nguyenduchan/keyboard_rs485/hardware/bom.csv

Qty | RefDes | Value | Footprint | Layer | Manufacturer | MPN | Notes | LCSC (JLCPCB) | JLC type
1 | U1 | STM32G030F6P6 | TSSOP-20 | Top | ST | STM32G030F6P6 | MCU; PA1 DE PA2/PA3 USART2; PA4-PA6 TM1638 open-drain; PA7 còi | C529330 | Extended
1 | U6 | TM1638 | SOP-28 300mil | Top | Titan Micro | TM1638 | Quét 2 module 4 số + 8 LED + 16 phím; thay thế AiP1638 / GN1638 | C19187 | Extended
1 | U3 | SP3485EN | SOIC-8 | Top | MaxLinear | SP3485EN-L/TR | RS485 3.3V | C8963 | Basic
1 | U4 | XL1509-5.0E1 | SOP-8 | Top | XLSEMI | XL1509-5.0E1 | Buck 24V→5V; FB nối +5V_RAW; ~EN nối GND | C61063 | Basic
1 | U5 | AMS1117-3.3 | SOT-223 | Top | AMS | AMS1117-3.3 | LDO 5V→3.3V | C6186 | Basic
2 | D8 DREV | SS34 | SMA | Top |  | SS34 | D8 diode buck; DREV chống ngược cực đầu vào | C8678 | Basic
1 | TVS1 | SMAJ28CA | SMA | Top |  | SMAJ28CA | TVS 2 chiều 28V tại VIN_PROTECT | C19077546 | Preferred
1 | TVS2 | PSM712-LF-T7 | SOT-23 | Top | ProTek | PSM712-LF-T7 | ESD/surge RS485 A/B, 34A 8/20us | C32677 | Basic
1 | F1 | mSMD050-33V | 1812 | Top |  | mSMD050-33V | Cầu chì tự phục hồi đầu vào | C70112 | Extended
1 | L1 | 47uH | SMD 6045 (6x6 mm) | Top |  | SWPA6045S470MT | Cuộn buck; Isat ≥ 0.8A | C36414 | Extended
4 | FBIN FB1 FB2 FB5V | Ferrite bead 0805 | 0805 | Top |  |  | FBIN GZ2012D601TF 600R; FB1/FB2/FB5V GZ2012D101TF 100R | C1017 / C1015 | Basic
1 | C4 | 470uF 35V | CP_Elec 10x10.5 SMD | Top |  | RVT1V471M1010 | Bulk +24V | C3350 | Extended
2 | C2 C22 | 220uF 10V | CP_Elec 6.3x5.4 SMD | Top |  | RVT1A221M0605 | +5V_RAW / +5V | C72494 | Extended
2 | C16 C19 | 2.2uF 50V X7R | 1206 | Top |  |  | HF tại VIN buck / VIN_PROTECT (bulk do C4) | C50254 | Basic
1 | C3 | 22uF | 0805 | Top |  |  | AMS1117 ngõ ra | C45783 | Basic
2 | C7 CLED3 | 10uF | 0805 | Top |  |  | AMS1117 ngõ vào; TM1638 VDD bulk | C15850 | Basic
2 | C15 C17 | 100nF 50V | 0805 | Top |  |  | HF trên rail 24V | C49678 | Basic
7 | C5 C18 CVDD1 CNRST CM3 CLED1 CLED2 | 100nF | 0805 | Top |  |  | Decoupling | C49678 | Basic
2 | R47A R47B | 47R | 0805 | Top |  |  | UART nối tiếp | C17714 | Basic
1 | RDE | 10k | 0805 | Top |  |  | Kéo DE xuống (mặc định nhận) | C17414 | Basic
1 | RBZG | 100k | 0805 | Top |  |  | Kéo cổng QBZ xuống | C149504 | Basic
3 | RSTB RCLK RDIO | 4.7k | 0805 | Top |  |  | Kéo lên +5V_LED cho 3 dây TM1638 | C17673 | Basic
2 | RBIAS_A RBIAS_B | 560R | 0805 | Top |  |  | Bias failsafe RS485 | C28636 | Basic
1 | RTERM | 120R | 0805 | Top |  |  | Termination (bật bằng JTERM) | C17437 | Basic
1 | JTERM | Solder jumper | SMD | Top |  |  | Hàn tắt ở node cuối bus (không phải linh kiện) |  | —
1 | NT1 | Net tie | SMD | Top |  |  | GND_PWR ↔ GND (không phải linh kiện) |  | —
1 | QBZ | 2N7002 | SOT-23 | Top |  | 2N7002 | Lái còi | C8545 | Basic
1 | BZ1 | Active buzzer 5V 12x9.5 | THT RM7.6 | Top (THT) |  | TMB12A05 | Còi chủ động; tự hàn |  | THT tự hàn
2 | DS1 DS2 | 5641AS 0.56in 4 digit CC | THT 12 pin | Bottom (THT) |  | 5641AS | Đỏ; tự hàn |  | THT tự hàn
16 | SW1-SW16 | Tact 12x12x7.3 B3F-4055 | THT 4 pin bước 12.5x5 (lỗ 1.3) | Bottom (THT) | Omron / loại tương đương | B3F-4055 | Trụ vuông nhận mũ A14 10x10; 2 chân cùng hàng cách 12.5 mm nối sẵn (1-2, 3-4 theo Omron), 4 lỗ Ø1.2 + 2 lỗ định vị Ø1.7 cách 9 mm; tự hàn; LCSC C84931 nếu cần |  | THT tự hàn
8 | D10-D17 | LED 3mm | THT | Bottom (THT) |  |  | Tự hàn |  | THT tự hàn
1 | J_PWR | Cọc vít 5.08mm 2P (KF301-5.08-2P) | THT 2 chân 5.08 (Panel:TerminalBlock_2P_5.08; lỗ 1.3) | Top (THT) | Kefa/Degson | KF301-5.08-2P | Nguồn +24V / GND; cọc vít cửa dây ngang ra cạnh phải; model 3D TerminalBlock_Phoenix MKDS 5.08; tự hàn |  | THT tự hàn
1 | J485 | Cọc vít 5.08mm 3P (KF301-5.08-3P) | THT 3 chân 5.08 (Panel:TerminalBlock_3P_5.08; lỗ 1.3) | Top (THT) | Kefa/Degson | KF301-5.08-3P | RS485 A / B / SG; cọc vít cửa dây ngang ra cạnh phải; model 3D TerminalBlock_Phoenix MKDS 5.08; tự hàn |  | THT tự hàn
1 | J_KEY | Pin header đực 1x10 2.54 thẳng | THT 1x10 + khe phay 2.6x28 | Top (THT) |  |  | Giắc bàn phím màng (song song 16 tact); 1 K1, 2 K2, 3–10 KS1–KS8; khe phay cho đuôi màng; model 3D PinHeader_1x10; tự hàn |  | THT tự hàn
1 | J_SWD | Pin header đực 1x4 2.54 thẳng | THT 1x4 (PinHeader_1x04_P2.54mm_Vertical) | Top (THT) |  |  | DAPLink nạp: 1 +3V3, 2 SWDIO, 3 SWCLK, 4 GND; model 3D PinHeader_1x04; tự hàn |  | THT tự hàn
1 | J_LOG | Pin header đực 1x4 2.54 thẳng | THT 1x4 (PinHeader_1x04_P2.54mm_Vertical) | Top (THT) |  |  | DAPLink log: 1 +3V3, 2 TX chip (PB6), 3 RX chip (PB7), 4 GND; model 3D PinHeader_1x04; tự hàn |  | THT tự hàn
16 | SW1-SW16 cap | Mũ nút nhấn 12x12 vuông kèm chụp nhựa trong | Mũ A14 lõi 10x10 cao 4.8 cắm trụ tact 12x12x7.3 | Mechanical |  | B3F-4055 vuông 12x12x7.3 | Shopee: lô 100 cái (mua 1 lô, dư 84); mũ vuông + chụp nhựa trong 11.8x11.8x3.9 để lồng decal/nhãn; 90.500đ/100 cái (~905đ/cái); mũ và chụp là một bộ, không tính thêm giá chụp |  | —
