nguyenduchan/keyboard_rs485/hardware/mechanical/cnc/D2-L8-M.dxf

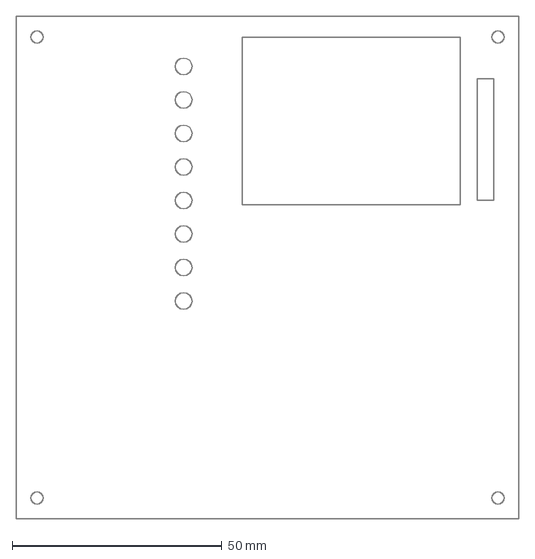
[picture p1: CAD file, 2026-10-09]
hardware/mechanical/cnc/D2-L8-M.dxf
120.0 x 120.0 mm
