nguyenduchan/keyboard_rs485/hardware/mechanical/cnc/D2-L0-K16.dxf

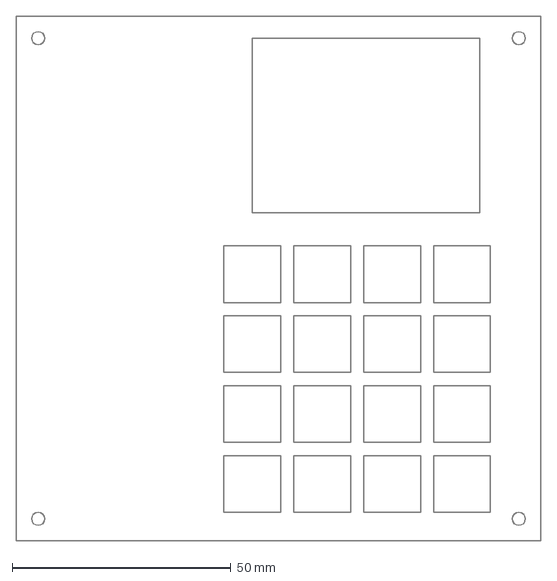
[picture p2: CAD file, 2026-10-09]
hardware/mechanical/cnc/D2-L0-K16.dxf
120.0 x 120.0 mm
