nguyenduchan/keyboard_rs485/hardware/mechanical/cnc/D0-L8-K16.dxf

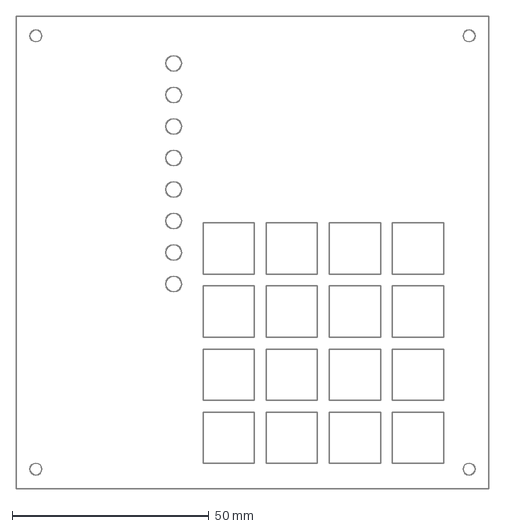
[picture p3: CAD file, 2026-10-09]
hardware/mechanical/cnc/D0-L8-K16.dxf
120.0 x 120.0 mm
