nguyenduchan/keyboard_rs485/hardware/mechanical/cnc/D2-L8-K0.dxf

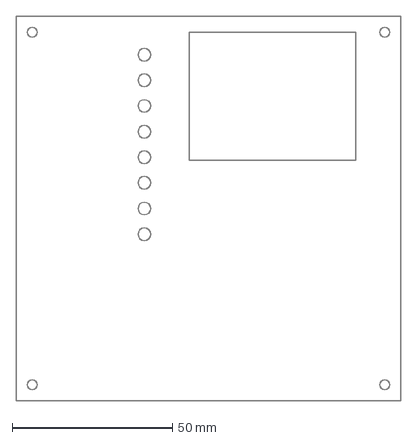
[picture p4: CAD file, 2026-10-09]
hardware/mechanical/cnc/D2-L8-K0.dxf
120.0 x 120.0 mm
