nguyenduchan/keyboard_rs485/hardware/mechanical/cnc/D1-L4-M.dxf

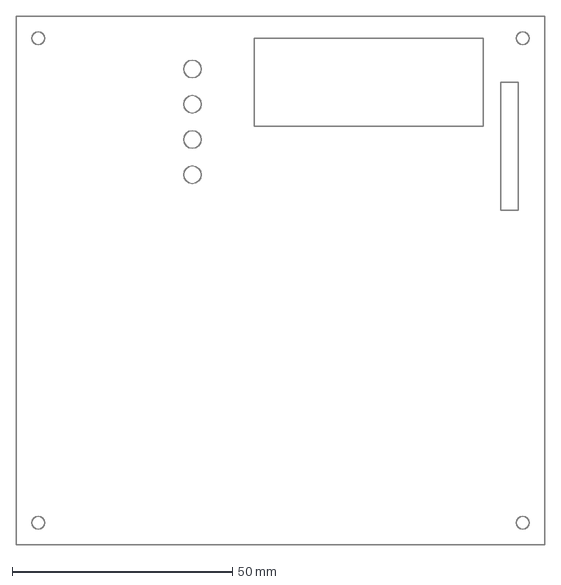
[picture p5: CAD file, 2026-10-09]
hardware/mechanical/cnc/D1-L4-M.dxf
120.0 x 120.0 mm
