nguyenduchan/keyboard_rs485/hardware/mechanical/cnc/D1-L4-K16.dxf

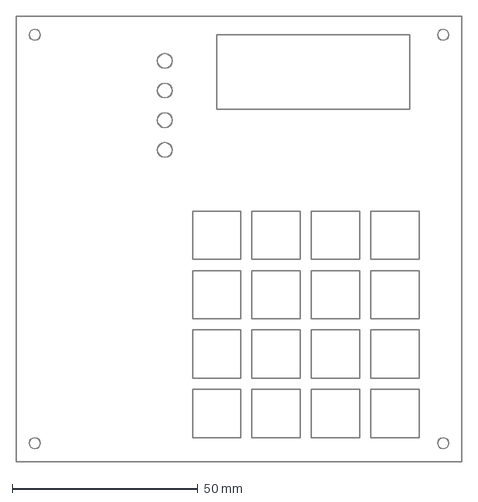
[picture p7: CAD file, 2026-10-09]
hardware/mechanical/cnc/D1-L4-K16.dxf
120.0 x 120.0 mm
