nguyenduchan/keyboard_rs485/hardware/mechanical/cnc/D0-L0-M.dxf

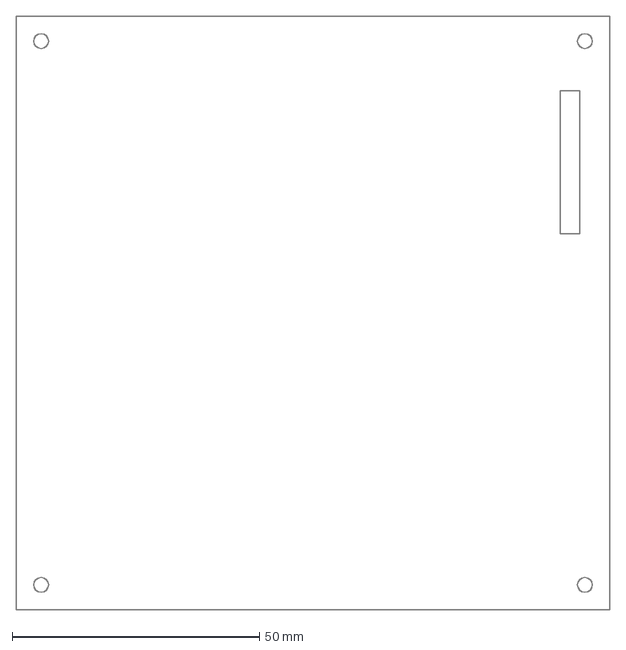
[picture p8: CAD file, 2026-10-09]
hardware/mechanical/cnc/D0-L0-M.dxf
120.0 x 120.0 mm
