nguyenduchan/keyboard_rs485/hardware/kicad/panel-keyboard/panel-keyboard.kicad_pcb

## KiCad design hardware/kicad/panel-keyboard/panel-keyboard.kicad_pcb (2026-10-09)

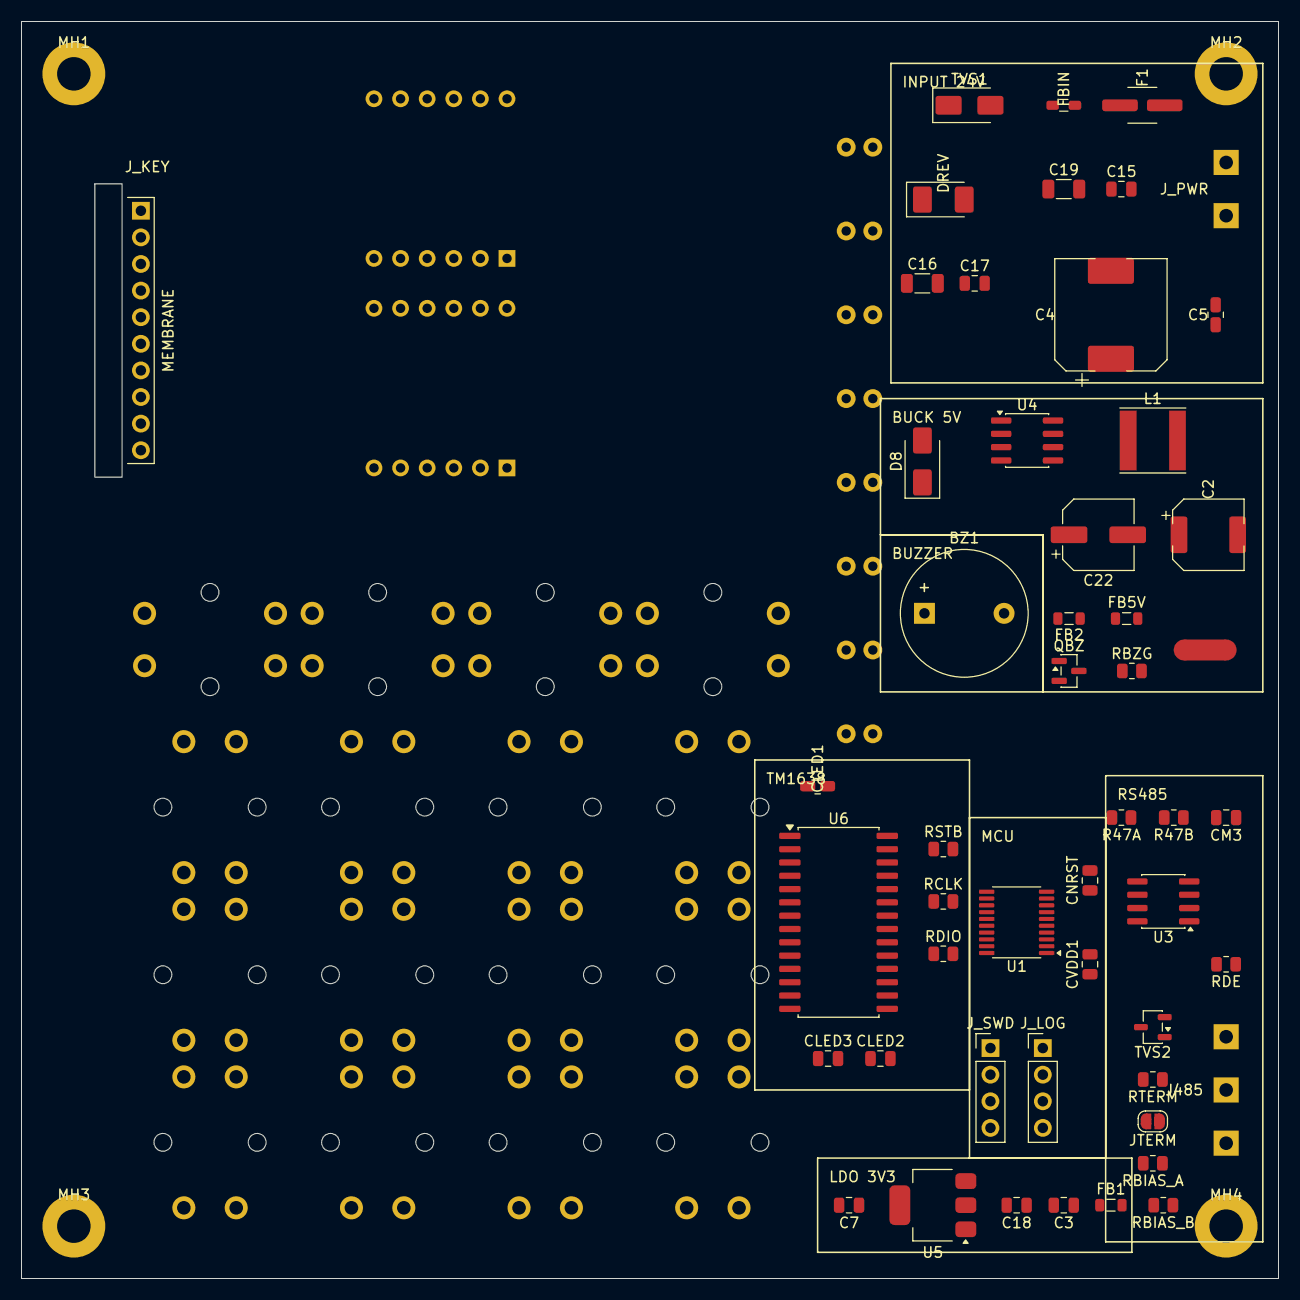
[picture p9: board panel-keyboard.kicad_pcb from above]

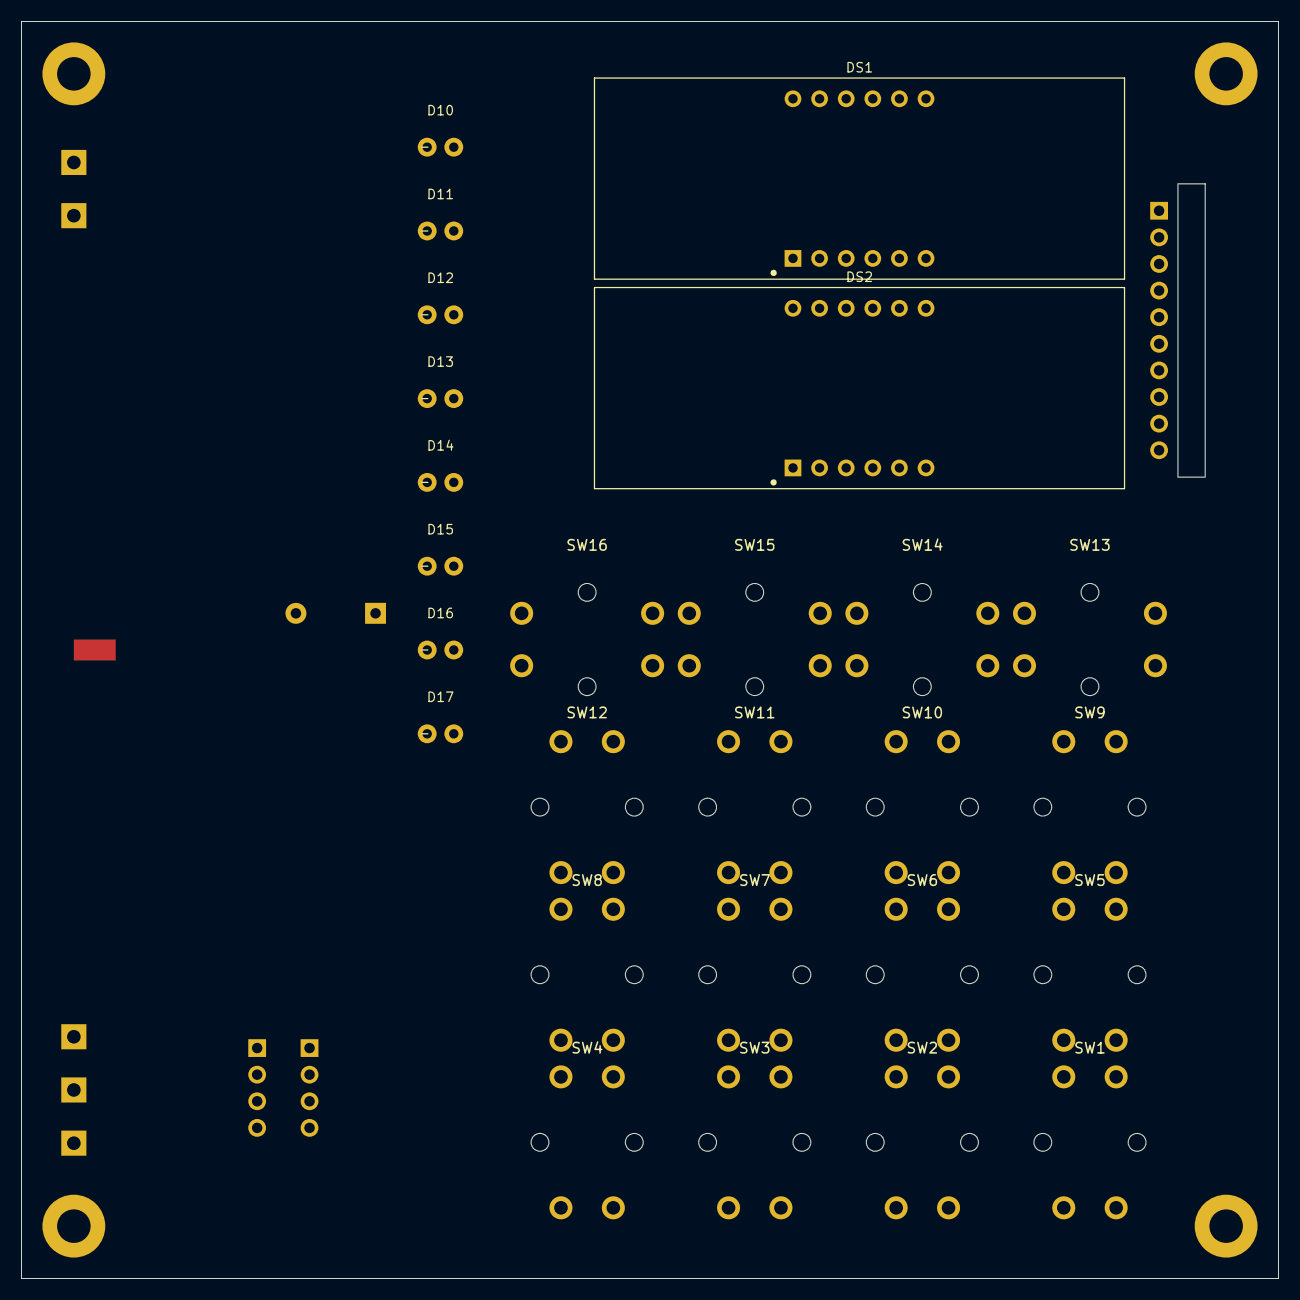
[picture p10: board panel-keyboard.kicad_pcb from below]

Board: 2 copper layers, 120.0 x 120.0 mm, 81 parts (26 on the bottom side), 49 nets, no tracks yet.

Parts:
BZ1: Active buzzer 5V 12x9.5; Buzzer_12x9.5RM7.6
C2, C22: 220uF 10V RVT1A221M0605; CP_Elec_6.3x5.4
C3: 22uF; C_0805_2012Metric
C4: 470uF 35V RVT1V471M1010; CP_Elec_10x10.5
C5, C18: 100nF; C_0805_2012Metric
C7: 10uF; C_0805_2012Metric
C15, C17: 100nF 50V; C_0805_2012Metric
C16, C19: 2.2uF 50V X7R; C_1206_3216Metric
CLED1, CLED2: 100nF; C_0805_2012Metric
CLED3: 10uF; C_0805_2012Metric
CM3: 100nF; C_0805_2012Metric
CNRST: 100nF; C_0805_2012Metric
CVDD1: 100nF; C_0805_2012Metric
D8: SS34; D_SMA
D10, D11, D12, D13, D14, D15, D16, D17: LED_3mm; LED_3mm_THT
DREV: SS34; D_SMA
DS1, DS2: 5641AS (4 digit 0.56in CC); Display_4digit_0.56in_THT
F1: mSMD050-33V (PPTC 0.5A 33V); Fuse_1812_4532Metric
FB1, FB2, FB5V: GZ2012D101TF 100R; L_0805_2012Metric
FBIN: GZ2012D601TF 600R; L_0805_2012Metric
J485: KF301-5.08-3P; TerminalBlock_3P_5.08
JTERM: 120R; SolderJumper-2_P1.3mm_Open_RoundedPad1.0x1.5mm
J_KEY: Membrane 1x10 2.54; Membrane_1x10_P2.54_Vertical_Slot
J_LOG: PinHeader_1x04_P2.54mm_Vertical
J_PWR: KF301-5.08-2P; TerminalBlock_2P_5.08
J_SWD: PinHeader_1x04_P2.54mm_Vertical
L1: SWPA6045S470MT 47uH; L_Taiyo-Yuden_NR-60xx
MH1, MH2, MH3, MH4: M3; MountingHole_M3
NT1: GND_STAR; NetTie-2_SMD_Pad2.0mm
QBZ: 2N7002; SOT-23
R47A, R47B: 47; R_0805_2012Metric
RBIAS_A: 560; R_0805_2012Metric
RBIAS_B: 560; R_0805_2012Metric
RBZG: 100k; R_0805_2012Metric
RCLK: 4.7k; R_0805_2012Metric
RDE: 10k; R_0805_2012Metric
RDIO: 4.7k; R_0805_2012Metric
RSTB: 4.7k; R_0805_2012Metric
RTERM: 120; R_0805_2012Metric
SW1, SW2, SW3, SW4, SW5, SW6, SW7, SW8, SW9, SW10, SW11, SW12, SW13, SW14, SW15, SW16: B3F-4055; SW_Tactile_12mm_THT
TVS1: SMAJ28CA; D_SMA
TVS2: PSM712-LF-T7; SOT-23-3
U1: STM32G030F6P6; TSSOP-20_4.4x6.5mm_P0.65mm
U3: SP3485EN; SOIC-8_3.9x4.9mm_P1.27mm
U4: XL1509-5.0E1; SOIC-8_3.9x4.9mm_P1.27mm
U5: AMS1117-3.3; SOT-223-3_TabPin2
U6: TM1638; SOIC-28W_7.5x17.9mm_P1.27mm

Connections:
+3V3: CM3.1, CVDD1.1, FB1.2, J_LOG.1, J_SWD.1, U1.4, U3.8
+3V3_LDO: C3.1, C18.1, FB1.1, U5.2
+5V: BZ1.1, C7.1, C22.1, FB2.2, FB5V.1, RBIAS_A.1, U5.3
+5V_LED: CLED1.1, CLED2.1, CLED3.1, FB5V.2, RCLK.1, RDIO.1, RSTB.1, U6.4, U6.15
+5V_RAW: C2.1, C5.1, FB2.1, L1.2, U4.3
+5V_SW: D8.1, L1.1, U4.2
+24V: C4.1, C16.1, C17.1, DREV.1, U4.1
+24V_FUSE: F1.2, FBIN.1
+24V_IN: F1.1, J_PWR.1
BZ_DRV: BZ1.2, QBZ.3
BZ_ON: QBZ.1, RBZG.1, U1.14
GND: C2.2, C3.2, C5.2, C7.2, C18.2, C22.2, CLED1.2, CLED2.2, CLED3.2, CM3.2, CNRST.2, CVDD1.2, J485.3, J_LOG.4, J_SWD.4, NT1.2, QBZ.2, RBIAS_B.2, RBZG.2, RDE.2, TVS2.3, U1.5, U3.5, U5.1, U6.18, U6.25
GND_PWR: C4.2, C15.2, C16.2, C17.2, C19.2, D8.2, J_PWR.2, NT1.1, TVS1.2, U4.4, U4.5, U4.6, U4.7, U4.8
GRID_1: D10.1, DS1.12, U6.24
GRID_2: D11.1, DS1.9, U6.23
GRID_3: D12.1, DS1.8, U6.22
GRID_4: D13.1, DS1.6, U6.21
GRID_5: D14.1, DS2.12, U6.20
GRID_6: D15.1, DS2.9, U6.19
GRID_7: D16.1, DS2.8, U6.17
GRID_8: D17.1, DS2.6, U6.16
KEY_K1: J_KEY.1, SW1.2, SW1.3, SW2.2, SW2.3, SW3.2, SW3.3, SW4.2, SW4.3, SW5.2, SW5.3, SW6.2, SW6.3, SW7.2, SW7.3, SW8.2, SW8.3, U6.1
KEY_K2: J_KEY.2, SW9.2, SW9.3, SW10.2, SW10.3, SW11.2, SW11.3, SW12.2, SW12.3, SW13.2, SW13.3, SW14.2, SW14.3, SW15.2, SW15.3, SW16.2, SW16.3, U6.2
LED_ROW: D10.2, D11.2, D12.2, D13.2, D14.2, D15.2, D16.2, D17.2, U6.13
LOG_RX: J_LOG.3, U1.1
LOG_TX: J_LOG.2, U1.20
MAX_DI: R47A.2, U3.4
MAX_RO: R47B.2, U3.1
NRST: CNRST.1, U1.6
RS485_A_BUS: J485.1, JTERM.1, RBIAS_A.2, TVS2.1, U3.6
RS485_B_BUS: J485.2, RBIAS_B.1, RTERM.2, TVS2.2, U3.7
RS485_DE: RDE.1, U1.8, U3.2, U3.3
RS485_TERM: JTERM.2, RTERM.1
SEG1: DS1.11, DS2.11, J_KEY.3, SW1.1, SW1.4, SW9.1, SW9.4, U6.5
SEG2: DS1.7, DS2.7, J_KEY.4, SW2.1, SW2.4, SW10.1, SW10.4, U6.6
SEG3: DS1.4, DS2.4, J_KEY.5, SW3.1, SW3.4, SW11.1, SW11.4, U6.7
SEG4: DS1.2, DS2.2, J_KEY.6, SW4.1, SW4.4, SW12.1, SW12.4, U6.8
SEG5: DS1.1, DS2.1, J_KEY.7, SW5.1, SW5.4, SW13.1, SW13.4, U6.9
SEG6: DS1.10, DS2.10, J_KEY.8, SW6.1, SW6.4, SW14.1, SW14.4, U6.10
SEG7: DS1.5, DS2.5, J_KEY.9, SW7.1, SW7.4, SW15.1, SW15.4, U6.11
SEG8: DS1.3, DS2.3, J_KEY.10, SW8.1, SW8.4, SW16.1, SW16.4, U6.12
SWCLK: J_SWD.3, U1.19
SWDIO: J_SWD.2, U1.18
TM_CLK: RCLK.2, U1.12, U6.27
TM_DIO: RDIO.2, U1.13, U6.26
TM_STB: RSTB.2, U1.11, U6.28
UART_RX: R47B.1, U1.10
UART_TX: R47A.1, U1.9
VIN_PROTECT: C15.1, C19.1, DREV.2, FBIN.2, TVS1.1
