nguyenduchan/keyboard_rs485/firmware/Core/Inc/main.h

#define TM_STB_Pin GPIO_PIN_4
#define TM_STB_GPIO_Port GPIOA
#define TM_CLK_Pin GPIO_PIN_5
#define TM_CLK_GPIO_Port GPIOA
#define TM_DIO_Pin GPIO_PIN_6
#define TM_DIO_GPIO_Port GPIOA
#define BZ_ON_Pin GPIO_PIN_7
#define BZ_ON_GPIO_Port GPIOA
