nguyenduchan/keyboard_rs485/(commit log)

2026-10-07 thiết kế pcb cho mạch bàn phím + led 7 thanh dùng rs485
    [bom.csv, panel-keyboard.kicad_pcb, panel-keyboard.kicad_sch]
2026-10-07 update layout và chip để mạch thành dạng hình vuông 120x120mm
    [bom.csv, panel-keyboard.kicad_pcb, panel-keyboard.kicad_sch]
2026-10-08 sửa danh sách linh kiện theo hương thương mại và add firmware cơ bản cho modbus
    [bom.csv, panel-keyboard.kicad_pcb, panel-keyboard.kicad_sch]
2026-10-09 tạo c# app, update firmware để bàn phím hỗ trợ cả 2 mode slave/master. hỗ trợ giắc nạp và debug trên board phù hợp với mạch nạp DAPLINK STM32 cổng Type-C
    [D0-L0-M.csv, D0-L0-M.dxf, D0-L8-K16.csv, D0-L8-K16.dxf, D1-L4-K16.csv, D1-L4-K16.dxf, D1-L4-M.csv, D1-L4-M.dxf]
